state-of-the-art/PianoLights/(commit log)

2020-07-12 First minimal implementation without bluetooth and just current keys HL
2020-07-15 Fixed issues with ble->usb proxy, now working well!
    [main.ino]
2020-07-16 Cleaned the logic, added betteh ghost notes handling & completed power budget
2020-07-18 Weird bug - not working without logging well. Probably bad BLE->USB buffer
    [main.ino]
2020-07-31 Completed documentation and added multiple power budgets
